ElektronikaDonBosco/Arduino-Audio-Meter/README.md

# Arduino-Audio-Meter.
Arduino bidez audio seinailea neurtzeko proiektua.
audio_meter_axo
# Zertan datza gure proeiktuak?
Arduino audio meter hau, gitarratik datorren seinalea irakurtzeko kapaza da. Sarreran txip amplifikagailu operazional baten bidez seinalea handitu eta arduinoak irakurri egiten du. Seinalea plasmatzeko, arduinoak inpultsu bidez LED matrizeetara bideratzen du seinalea, LED-ak piztuz eta hainbat forma, irudi sortuz.
audio_meter_parts
# Funtzionamendua:
Jatorrizko audio-sarrera ez ukitzeko eta ez aldatzeko diseinatuta dago zirkuitua. ADC Arduinoak gitarraren seinalea irakurriko du LED pantailaren animazioa sortzeko, zaratarik eta aldaketarik gehitu gabe. Zirkuituak 3 bloke ditu: sarrera Etapa eta LED Matrizeak eta Elikadura Iturria:
hardware-configuration
- Sarrera analogikoko etapa: audio-sarrerako seinale ahula anplifikatu eta iragazten da, UNO ADC Arduinorako prestatuz (Konbertitzaile analogikotik digitalera). Errailetik errailerako anplifikadore operazionala (MCP6002) erabiltzen da seinalea anplifikatzeko (2-30 aldiz irabazi-potentziometroaren arabera), audio-sarrerako edozein seinale erabili ahal izateko.

- 8x8ko LED kontrolagailuak eta matrizeak: "Anodo arrunteko" lau matrize erabiltzen dira 16x16ko pantaila bat sortzeko. Lau MAX7219 txip erabiltzen dira matrizeak kontrolatzeko. Arduino UNO eta LED lineen arteko komunikazioa 3 DIN (Data IN), CLK (erlojua) eta Carga lineen bidez egiten da. LED Arduino liburutegi estandarra (LedControl.h) adibide gehienetan erabiltzen da.

- Elikadura-iturria: LED 8X8ren lau matrizeren erabilerak 4x8x8 = 256 LED egiten du guztira, eta, beraz, korrontea 500 mA-raino handitu daiteke (Vin = 9 a 12 V). Horregatik erabiltzen dugu VXO7805-1000 bat (1A gehienezko irteera-korrontea izateko gai dena). 7805 estandarrago bat ere erabil liteke, baina berotu egiten da.
Arduino-Audio-Meter_Schematic_simple
# Nola programatu:

Proiektua ahalik eta errazena programatzeko, Arduinoko IDE estandarra erabiliko dugu. Efektu guztiak C formatuan programatuta daude. Tresna eta programa guztiak doakoak/kode irekikoak dira. 8x8ko LED matrizeak kontrolatzeko, LedControl liburutegia erabiltzen dugu.

https://www.electrosmash.com/forum/arduino-audio-meter/485-how-to-start-programming-the-arduino-audio-meter programatzen hasteko link-a
