ElektronikaDonBosco/Arduino-Audio-Meter/Proteus/Arduino-Audio-Meter_Schematic.pdf

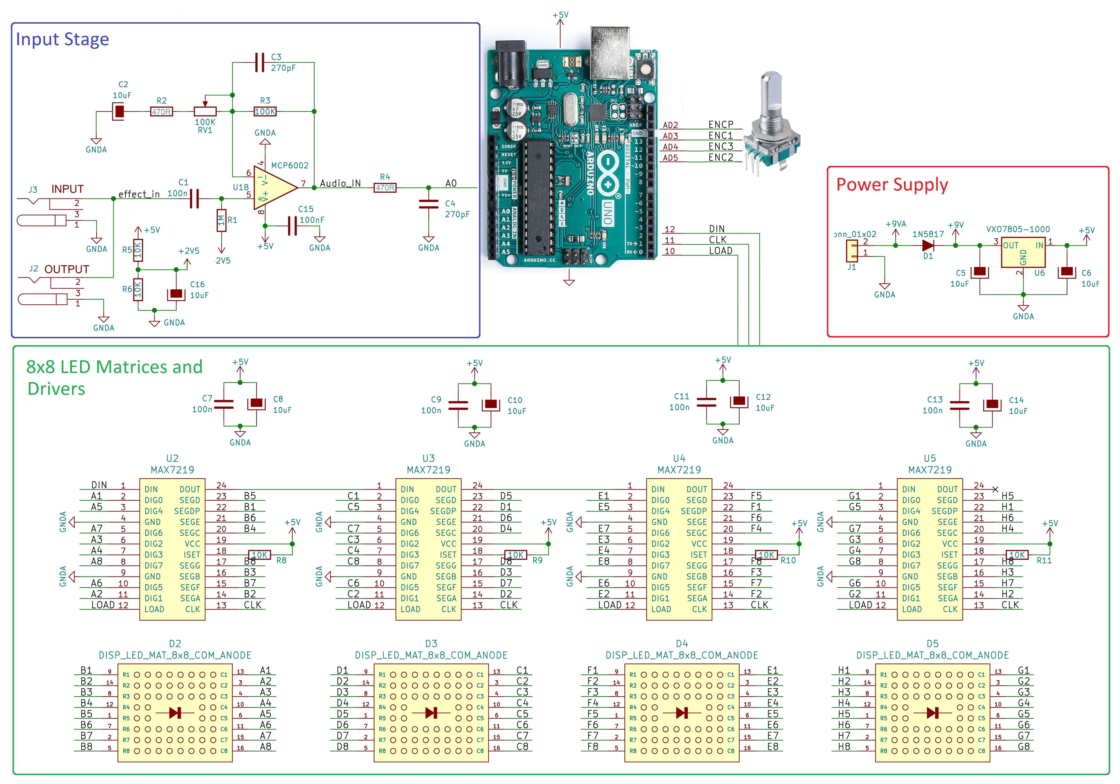
[picture p1: page 1]
