ElektronikaDonBosco/Arduino-Audio-Meter/PCBa sortzeko plantilla/Arduino-Audio-Meter_PCB_Plan.pdf

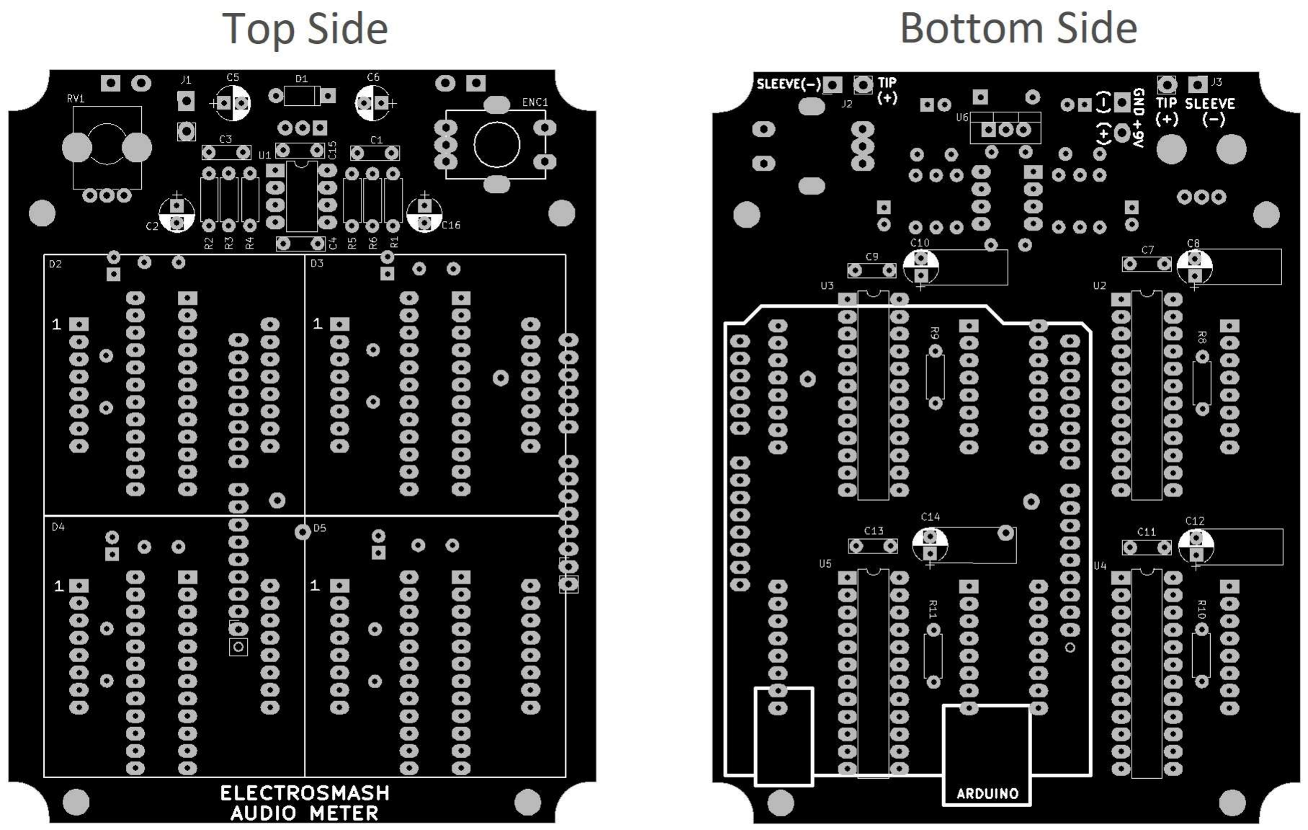
[picture p2: page 1]
