ElektronikaDonBosco/Arduino-Audio-Meter/Kaxaren tamainua eta zuloak/Arduino-Audio-Meter_1590BBS_Drilling-Stencil.pdf

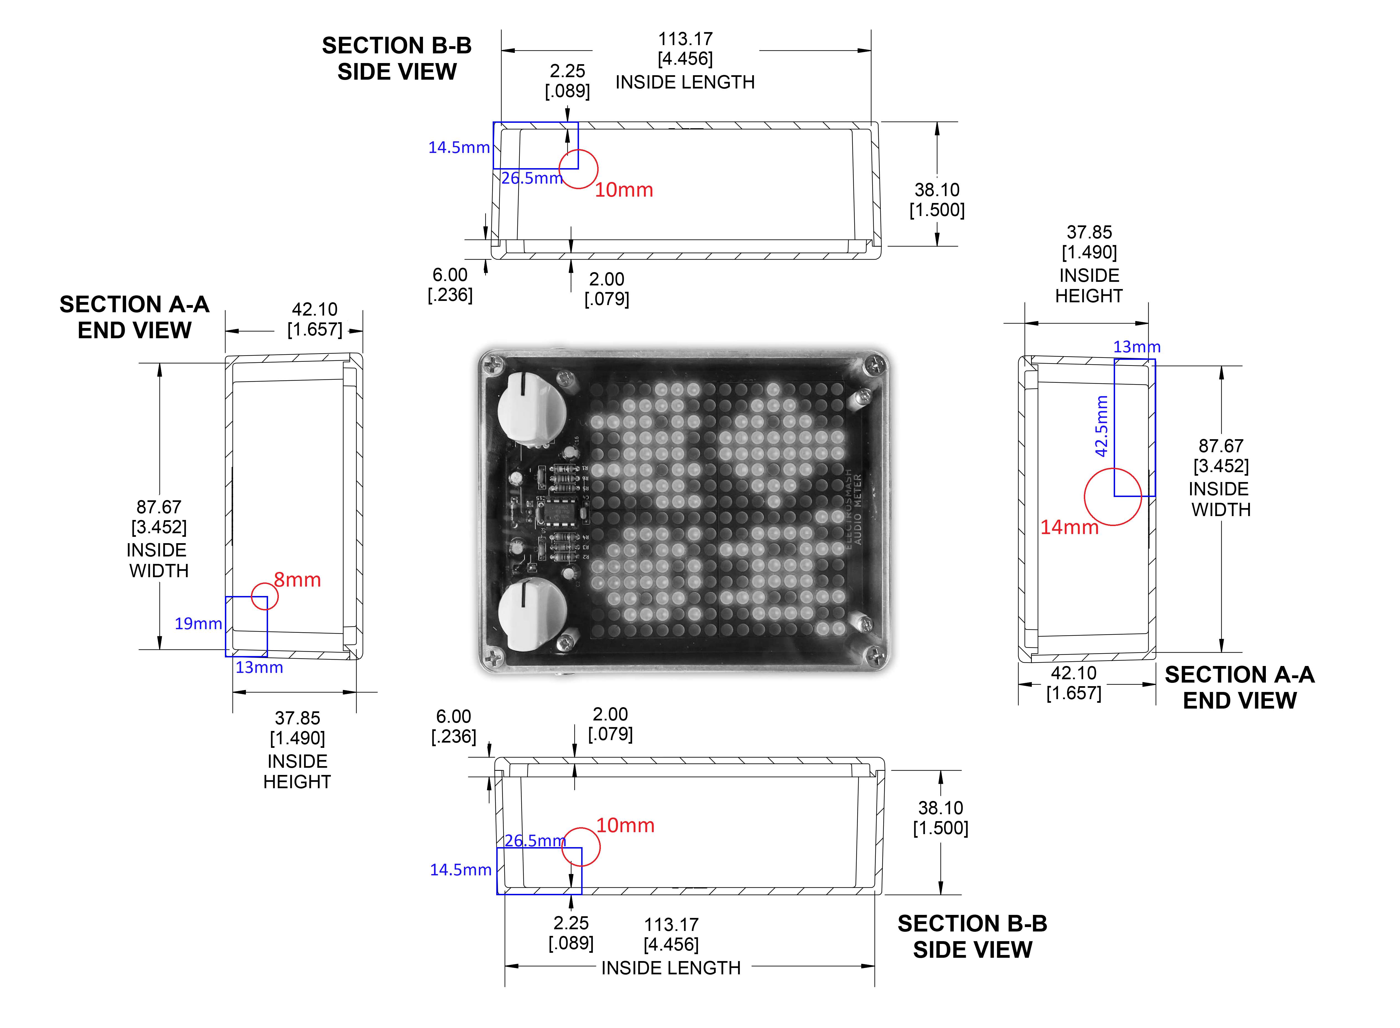
[picture p3: page 1]
