ElektronikaDonBosco/Arduino-Audio-Meter/(list of files, drawings)

Other design files:
Proteus/ARDUINO FINAL t20_2.0.pdsprj
