ElektronikaDonBosco/Arduino-Audio-Meter/Montaketa gida/Arduino-Audio-Meter_Assembly_Guide.pdf

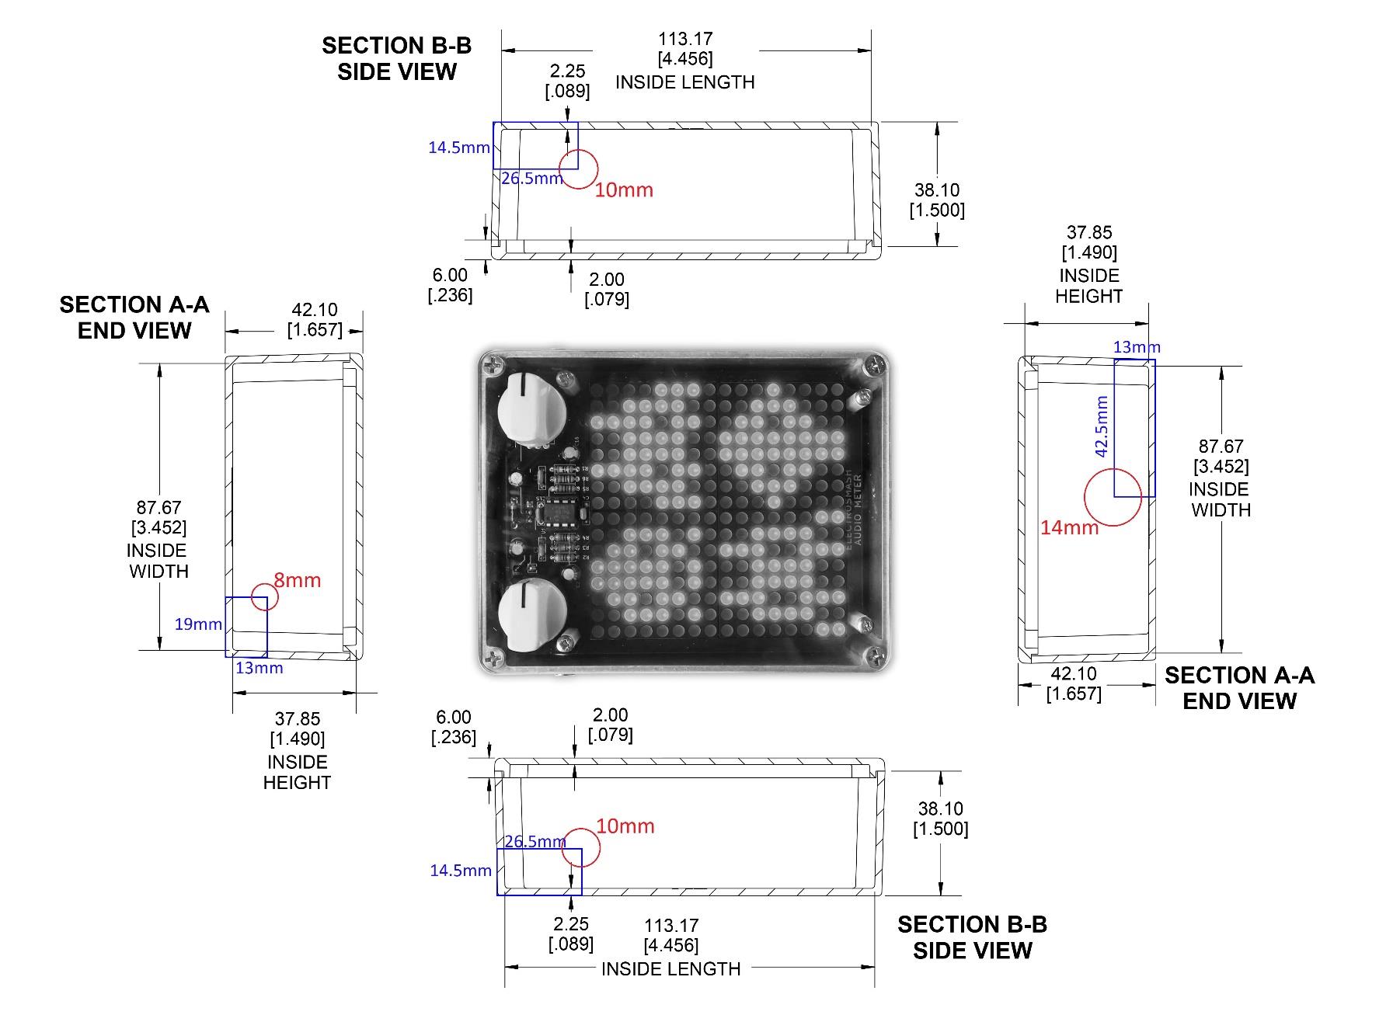
[picture p25: figure]
