ElektronikaDonBosco/Arduino-Audio-Meter/Montaketa gida/Arduino-Audio-Meter_Assembly_Guide.pdf

How to Build the Arduino Audio Meter.

This document will guide you to build and test your Arduino Audio Meter guitar pedal. With all the materials on hand, it takes around 2-3 hours to build it. Try not to rush and take your time to do it.

We strongly recommend reviewing the entire instructions before starting. It takes 2 minutes to get a global idea of the build and may save you hours of frustration (some details like the 8x8 LED orientation is crucial, desoldering is a tedious task).

This guide aims to build and test the circuit at the same time in a logical order: placing the components from small to big and testing.

STEP 0 – Prepare the Materials.

You would need:

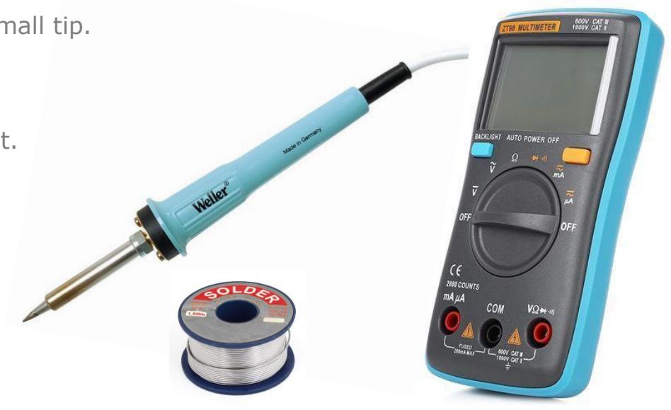
[picture p4: figure]

- Soldering iron with a small tip.
- Solder wire.
- Cutting pliers.
- Multimeter.
- Arduino Audio Meter Kit.

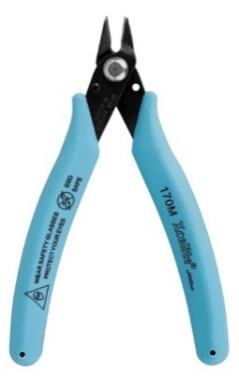
[picture p5: figure]

Keep in shorthand the important documents:

- PCB Plan PDF. (https://www.electrosmash.com/images/tech/arduino-audio-meter/Arduino-Audio-Meter_PCB_Plan.pdf)
- Schematic PDF. (https://www.electrosmash.com/images/tech/arduino-audio-meter/Arduino-Audio-Meter_Schematic.pdf)
- Bill of Materials PDF. (https://www.electrosmash.com/images/tech/arduino-audio-meter/Arduino-Audio-Meter_BOM.pdf)
- 1590BBS Arduino Audio Meter Drilling Stencil PDF. (https://www.electrosmash.com/images/tech/arduino-audio-meter/Arduino-Audio-Meter_1590BBS_Drilling-Stencil.pdf)

## STEP 1 – Soldering Resistors:

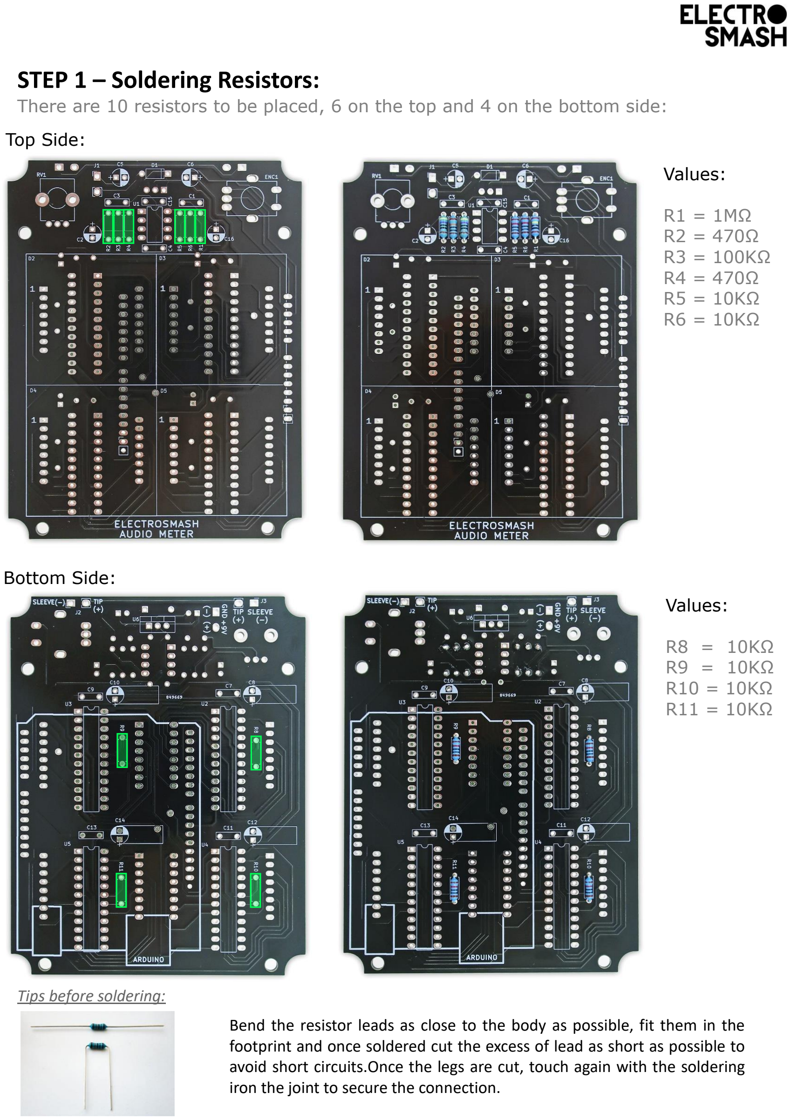
[picture p6: page 2]

Values:

R1 = 1MΩ
R2 = 470Ω
R3 = 100KΩ
R4 = 470Ω
R5 = 10KΩ
R6 = 10KΩ

Top Side:

Bottom Side:
Values:

R8 = 10KΩ
R9 = 10KΩ
R10 = 10KΩ
R11 = 10KΩ

There are 10 resistors to be placed, 6 on the top and 4 on the bottom side:

Tips before soldering:
Bend the resistor leads as close to the body as possible, fit them in the footprint and once soldered cut the excess of lead as short as possible to avoid short circuits.Once the legs are cut, touch again with the soldering iron the joint to secure the connection.

## STEP 2 – Soldering the Caps:

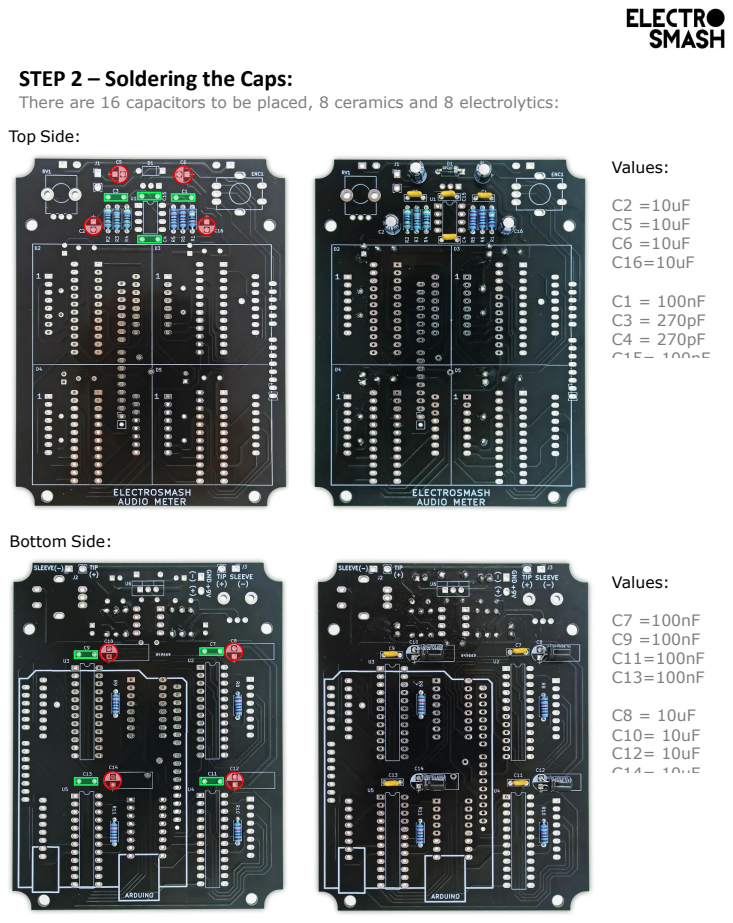
[picture p7: page 3]

There are 16 capacitors to be placed, 8 ceramics and 8 electrolytics:

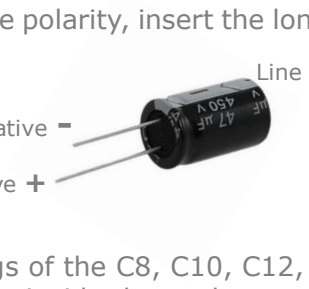
[picture p8: figure]

Long lead, positive +

Short lead, negative -

Line marked on the negative side

Note: The electrolytic caps have polarity, insert the long lead into the hole labelled with “+”

You would need to bend the legs of the C8, C10, C12, C14 caps in a 90° angle so they won’t crash with any other parts inside the enclosure.

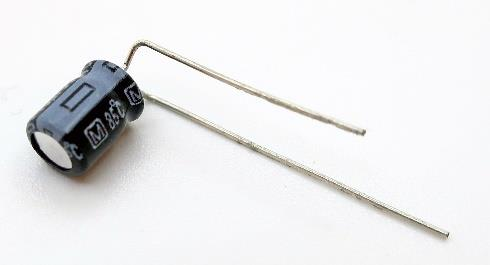
[picture p9: figure]

## STEP 3 – Soldering Big Components:

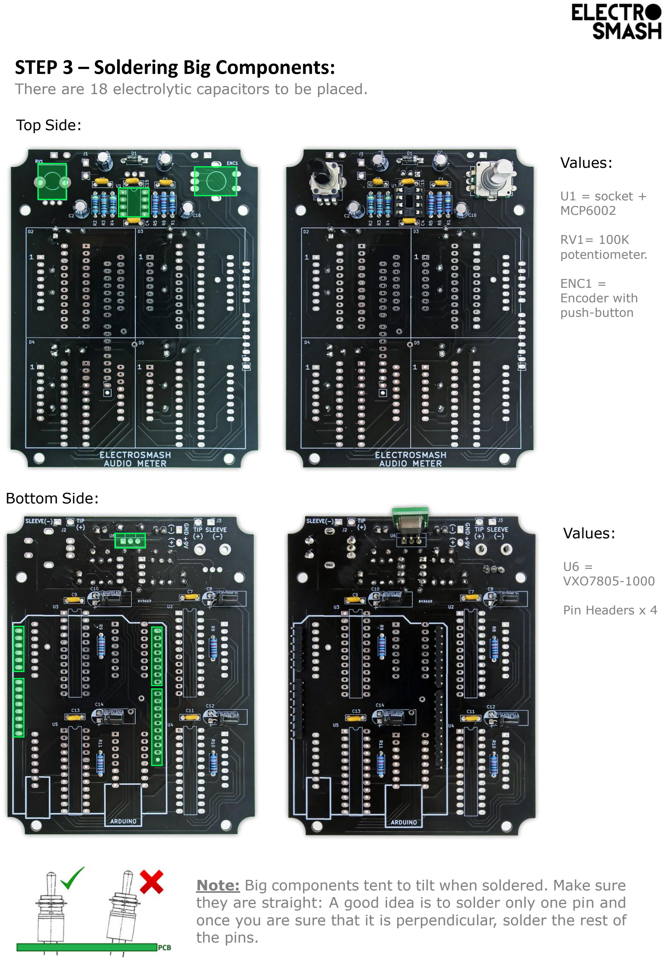
[picture p10: page 5]

Top Side:

Bottom Side:

Note: Big components tent to tilt when soldered. Make sure they are straight: A good idea is to solder only one pin and once you are sure that it is perpendicular, solder the rest of the pins.

Values:

U1 = socket +
MCP6002

RV1= 100K
potentiometer.

ENC1 =
Encoder with
push-button

Values:

U6 =
VXO7805-1000

Pin Headers x 4

There are 18 electrolytic capacitors to be placed.

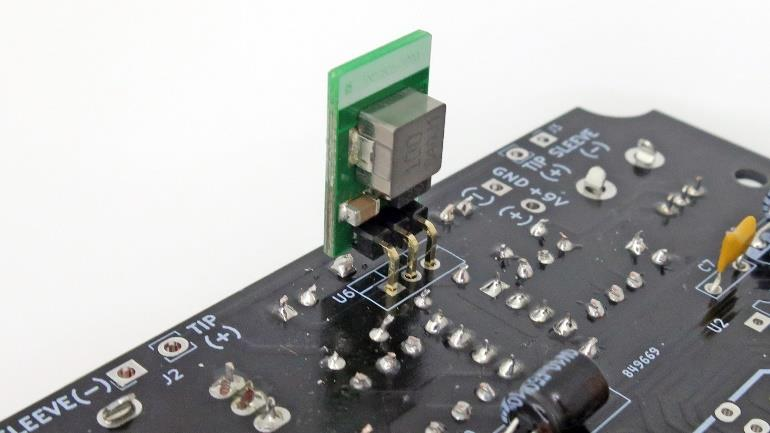
[picture p11: figure]
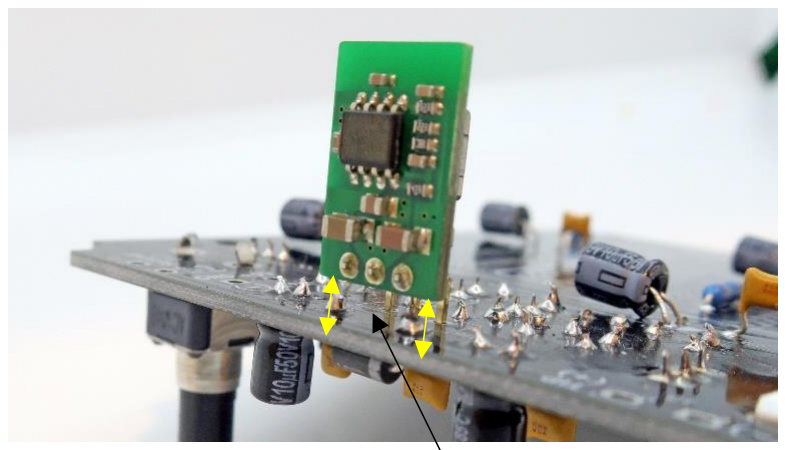
[picture p12: figure]

Clearance between the board and the chip

Make sure that the 9V to 5V regulator (U6) is soldered with some space between the PCB and the part, so short circuits are avoided:

Note: The 40 pins strip needs to be cut into smaller pieces (10, 8, 8, and 6 pins).

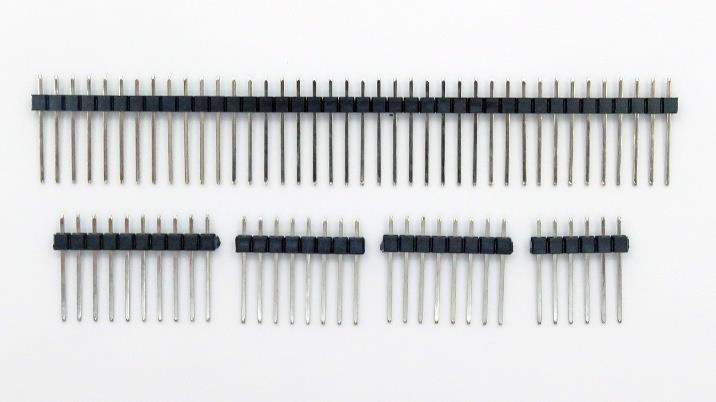
[picture p13: figure]

## STEP 4 – Solder one LED matrix and test it:

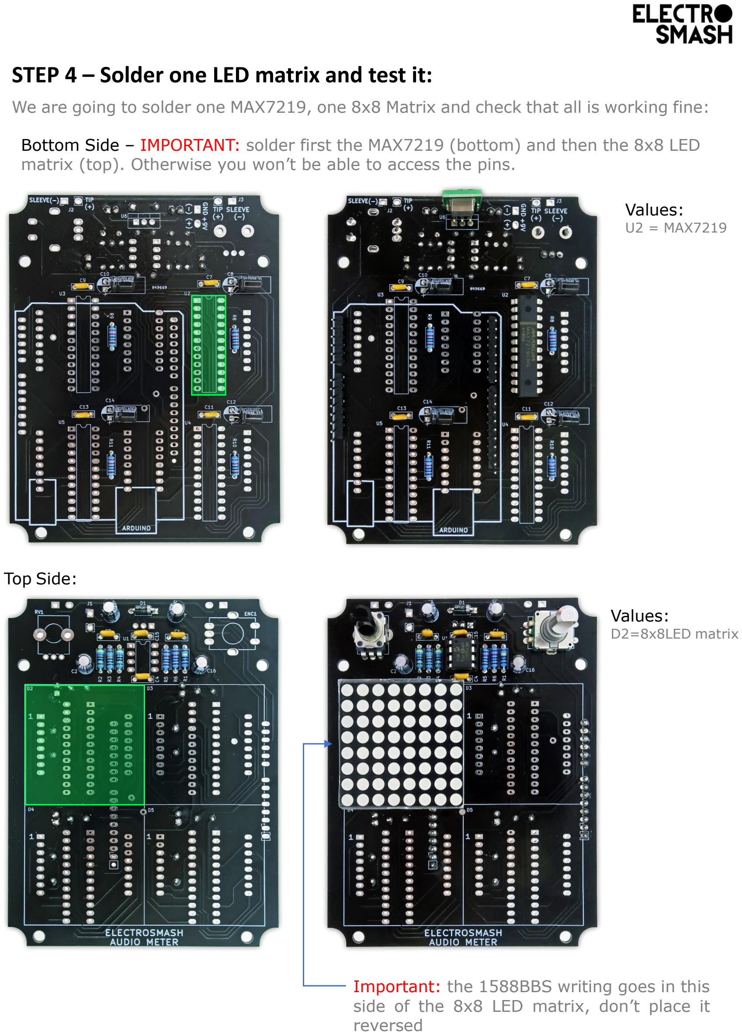
[picture p14: page 7]

Bottom Side – IMPORTANT: solder first the MAX7219 (bottom) and then the 8x8 LED matrix (top). Otherwise you won’t be able to access the pins.

Top Side:

Important: the 1588BBS writing goes in this side of the 8x8 LED matrix, don’t place it reversed

Values:
U2 = MAX7219

Values:
D2=8x8LED matrix

We are going to solder one MAX7219, one 8x8 Matrix and check that all is working fine:

Testing:

After installing one 8x8LED matrix, you can use the Test_one_8x8LED.ino program from the forum (https://www.electrosmash.com/forum/arduino-audio-meter/496-arduino-codes-to-test-the-8x8-led-matrix) to check that all is working fine:

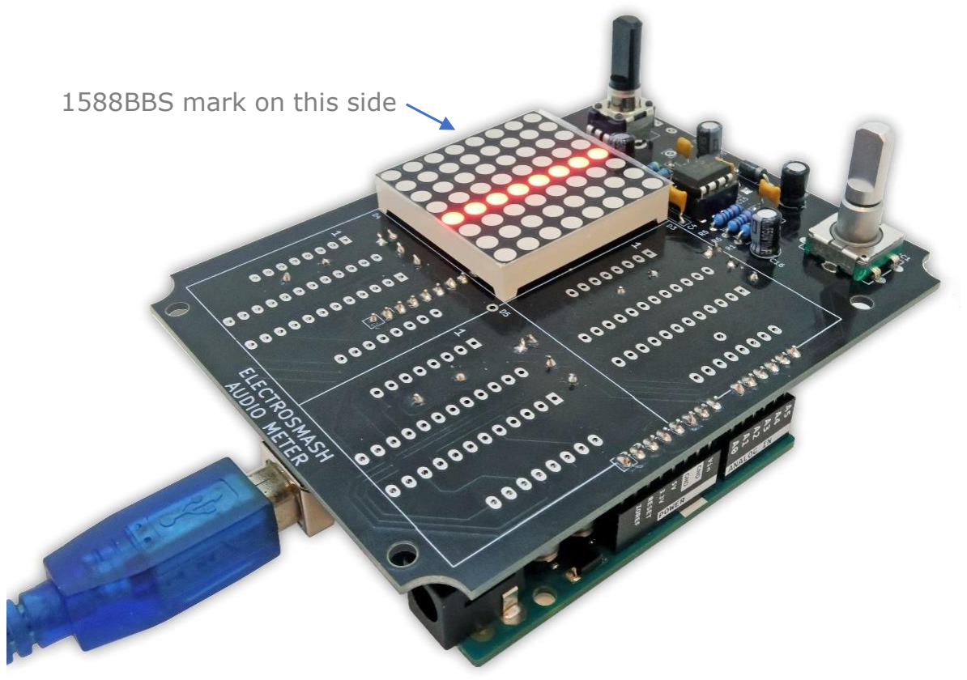
[picture p15: figure]
1588BBS mark on this side

The code will light up one column of LEDs and move it from left to right.

Note: You do not need external power supply for this, you can use the USB cable to power the system.

## STEP 5 – Soldering the rest of the 8x8 LEDs and drivers

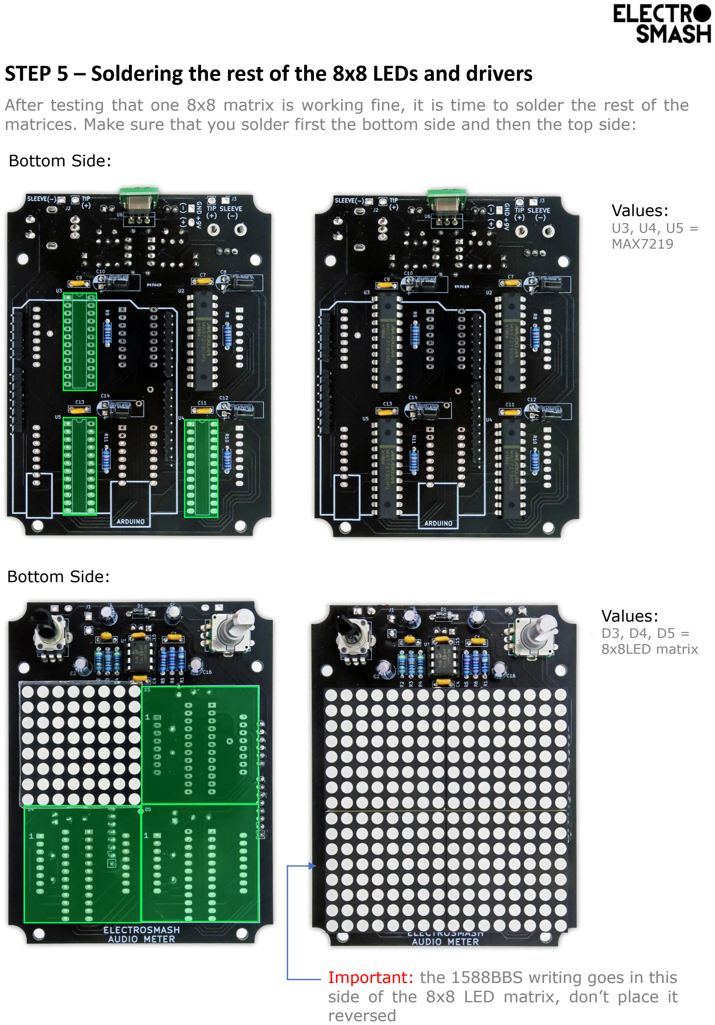
[picture p16: page 9]

Bottom Side:

Bottom Side:

Important: the 1588BBS writing goes in this side of the 8x8 LED matrix, don’t place it reversed

Values:
U3, U4, U5 =
MAX7219

Values:
D3, D4, D5 =
8x8LED matrix

After testing that one 8x8 matrix is working fine, it is time to solder the rest of the matrices. Make sure that you solder first the bottom side and then the top side:

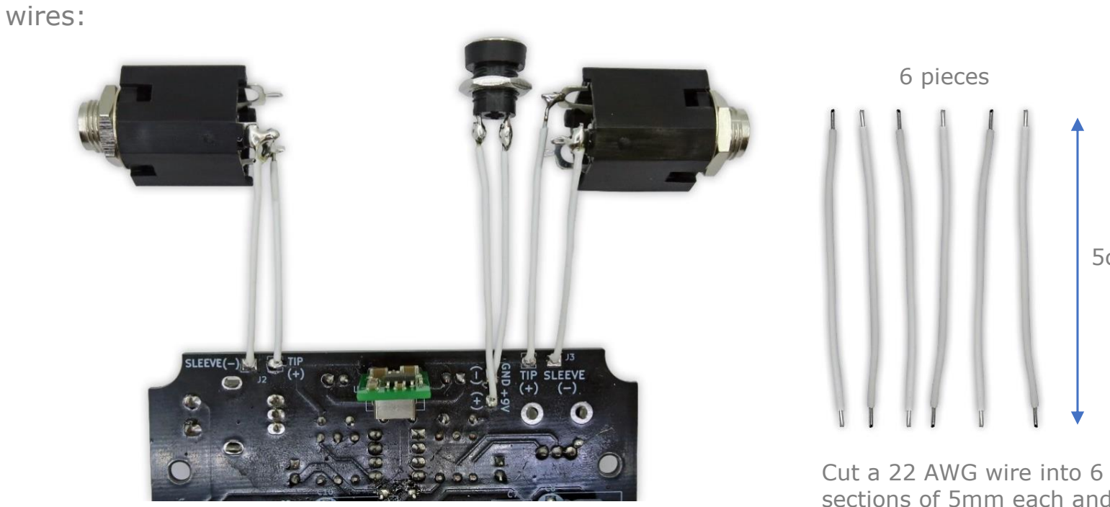
[picture p17: figure]
Cut a 22 AWG wire into 6; 6 pieces; wires:

5cm

Using 2 short wires (5cm) connect the Tip on the Audio Jack to the pad labelled as TIP(+) on the PCB. Do the same with the Sleeve and SLEEVE (-).

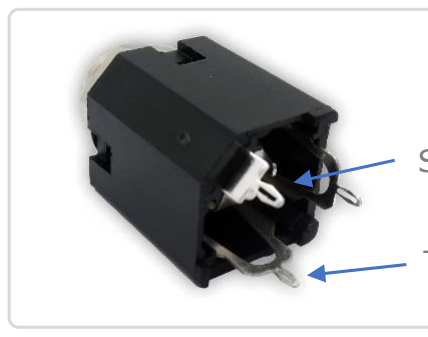
[picture p18: figure]

Tip

Sleeve

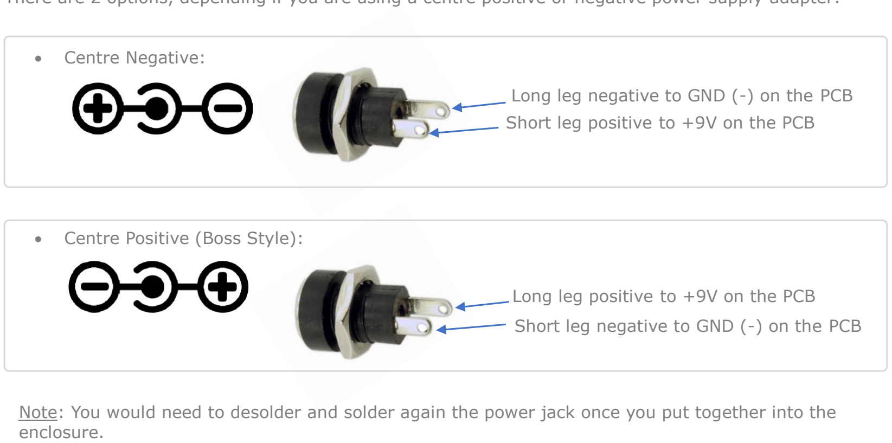
[picture p19: figure]
Long leg negative to GND (-) on the PCB; Short leg positive to +9V on the PCB; Long leg positive to +9V on the PCB; enclosure.; • Centre Negative:; • Centre Positive (Boss Style):

Short leg negative to GND (-) on the PCB

sections of 5mm each and
strip the extremes.

Note: You would need to desolder and solder again the power jack once you put together into the

## STEP 6 – Solder the wired components:

The last step is to solder the input/output jacks and the 9V-12V DC jack using 6 short

Soldering the ¼” Audio Jacks:

Soldering the 2.1mm DC Jack:

You can use any power supply from 9V to 12V, but they should give at least 600mA of output current. There are 2 options, depending if you are using a centre positive or negative power supply adapter:

## STEP 7 – Checking the Board Voltages:

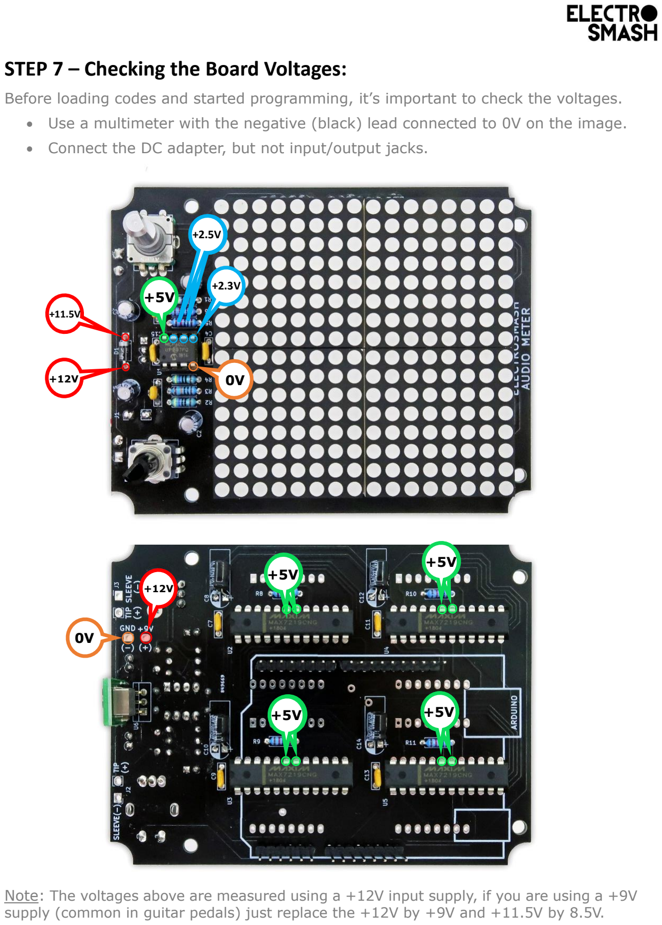
[picture p20: page 11]

Before loading codes and started programming, it’s important to check the voltages.

- Use a multimeter with the negative (black) lead connected to 0V on the image.
- Connect the DC adapter, but not input/output jacks.

Note: The voltages above are measured using a +12V input supply, if you are using a +9V supply (common in guitar pedals) just replace the +12V by +9V and +11.5V by 8.5V.

+12V

+5V | +5V

+5V

+5V

+11.5V

0V

0V

+5V

+2.5V

+2.3V

+12V

STEP 8 – Final Test.

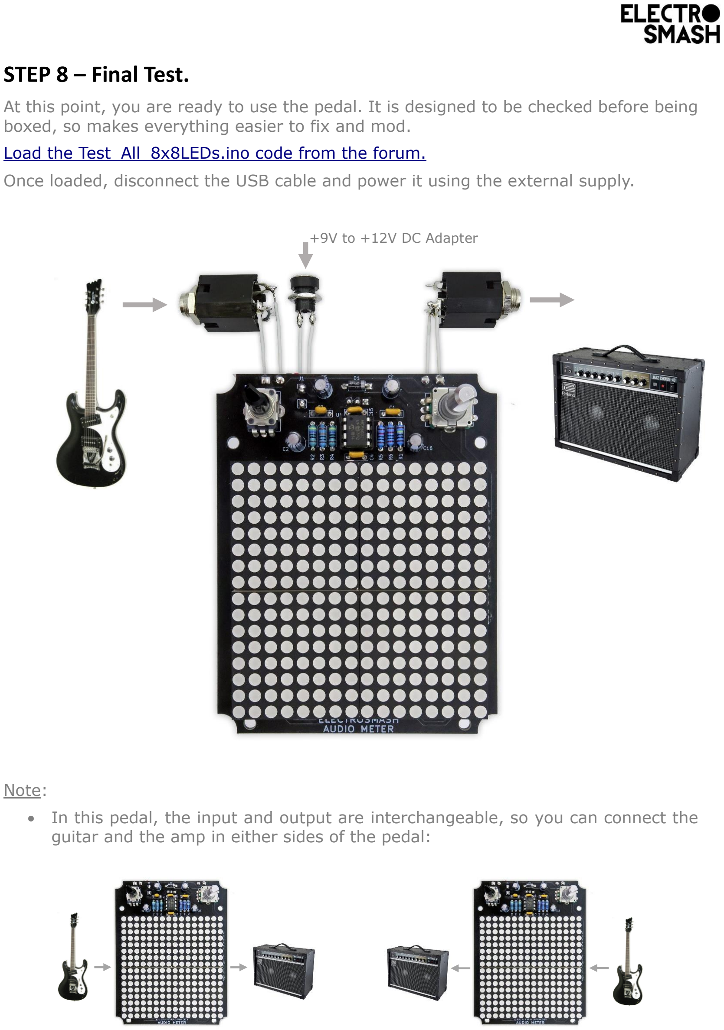
[picture p21: page 12]

J7-Input | J2-Output

+9V to +12V DC Adapter

At this point, you are ready to use the pedal. It is designed to be checked before being boxed, so makes everything easier to fix and mod.

Load the Test_All_8x8LEDs.ino code from the forum. (https://www.electrosmash.com/forum/arduino-audio-meter/496-arduino-codes-to-test-the-8x8-led-matrix)

Once loaded, disconnect the USB cable and power it using the external supply.

Note:

- In this pedal, the input and output are interchangeable, so you can connect the guitar and the amp in either sides of the pedal:

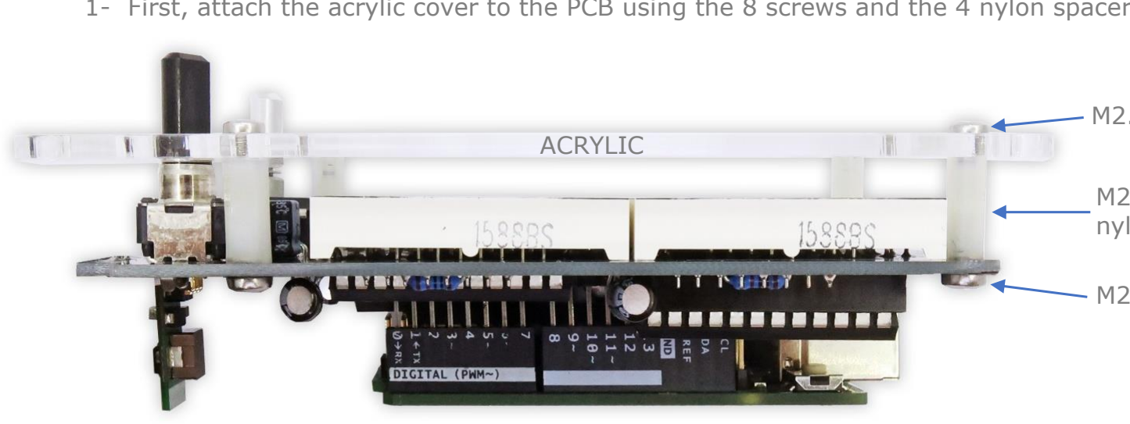
[picture p22: figure]
ACRYLIC

M2.5x12mm
nylon spacer

M2.5x8mm screw

M2.5x8mm screw

## STEP 8 - Mount the Pedal into the Enclosure:

The last step is to put all together into the Hammond 1590BBS box:

1- First, attach the acrylic cover to the PCB using the 8 screws and the 4 nylon spacers.

Note: Do not overtight the screws that touch the acrylic. Make sure that they go firm but be gentle not to break the acrylic cover.

2- Plug the Arduino UNO Board.

3- Fix the audio jacks and DC jack connector to the enclosure with nuts.

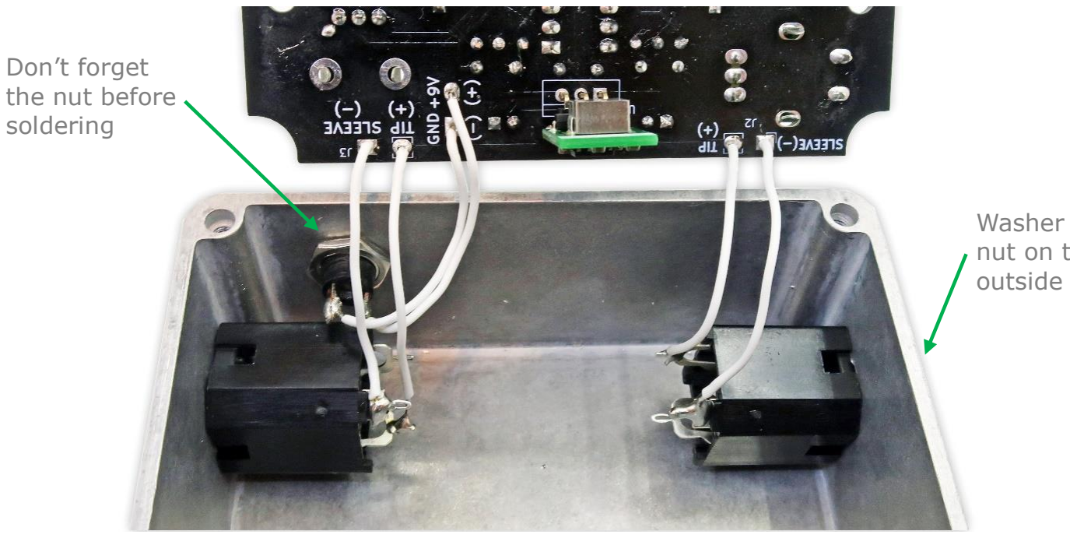
[picture p23: figure]
Don’t forget the nut before soldering; outside

- You may need to unsolder/solder again the DC jack (make sure that the polarity is right).
- Make sure that all the soldered parts have their legs cut as close as possible to the PCB

Washer and
nut on the

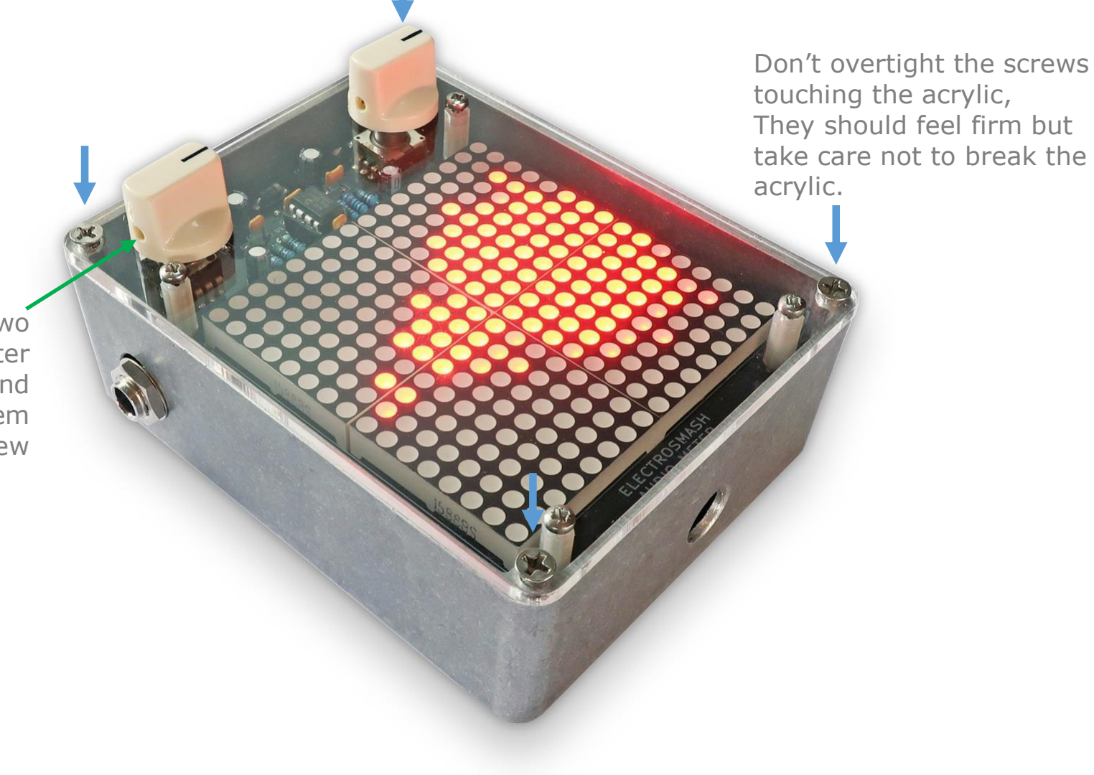
[picture p24: figure]
touching the acrylic, They should feel firm but take care not to break the acrylic.

Don’t overtight the screws

Fit the two
potentiometer
knobs and
adjust them
with the screw

4- Finally put the board into the Box, make sure that all goes tight but there are no short circuits and the regulator is not touching the metal enclosure.

Once the build is finished, you can go to the “How to Start Programming the Arduino Audio Meter” (https://www.electrosmash.com/forum/arduino-audio-meter/485-how-to-start-programming-the-arduino-audio-meter) in the forum.

Appendix: Enclosure Drilling Stencil.

The project is designed to fit in a Hammond 1590BBS enclosure, there are more models in different colors with a different reference number (1590BBSYL, 1590BBSRD, 1590BBSPR, 1590BBSOR, 1590BBSLG, 1590BBSGR, 1590BBSCB, 1590BBSBK)

This is the Hammond 1590BBS drill stencil, you can also download the PDF (https://www.electrosmash.com/images/tech/arduino-audio-meter/Arduino-Audio-Meter_1590BBS_Drilling-Stencil.pdf) file.
